freetronics/ServoShield/ServoShield.pdf

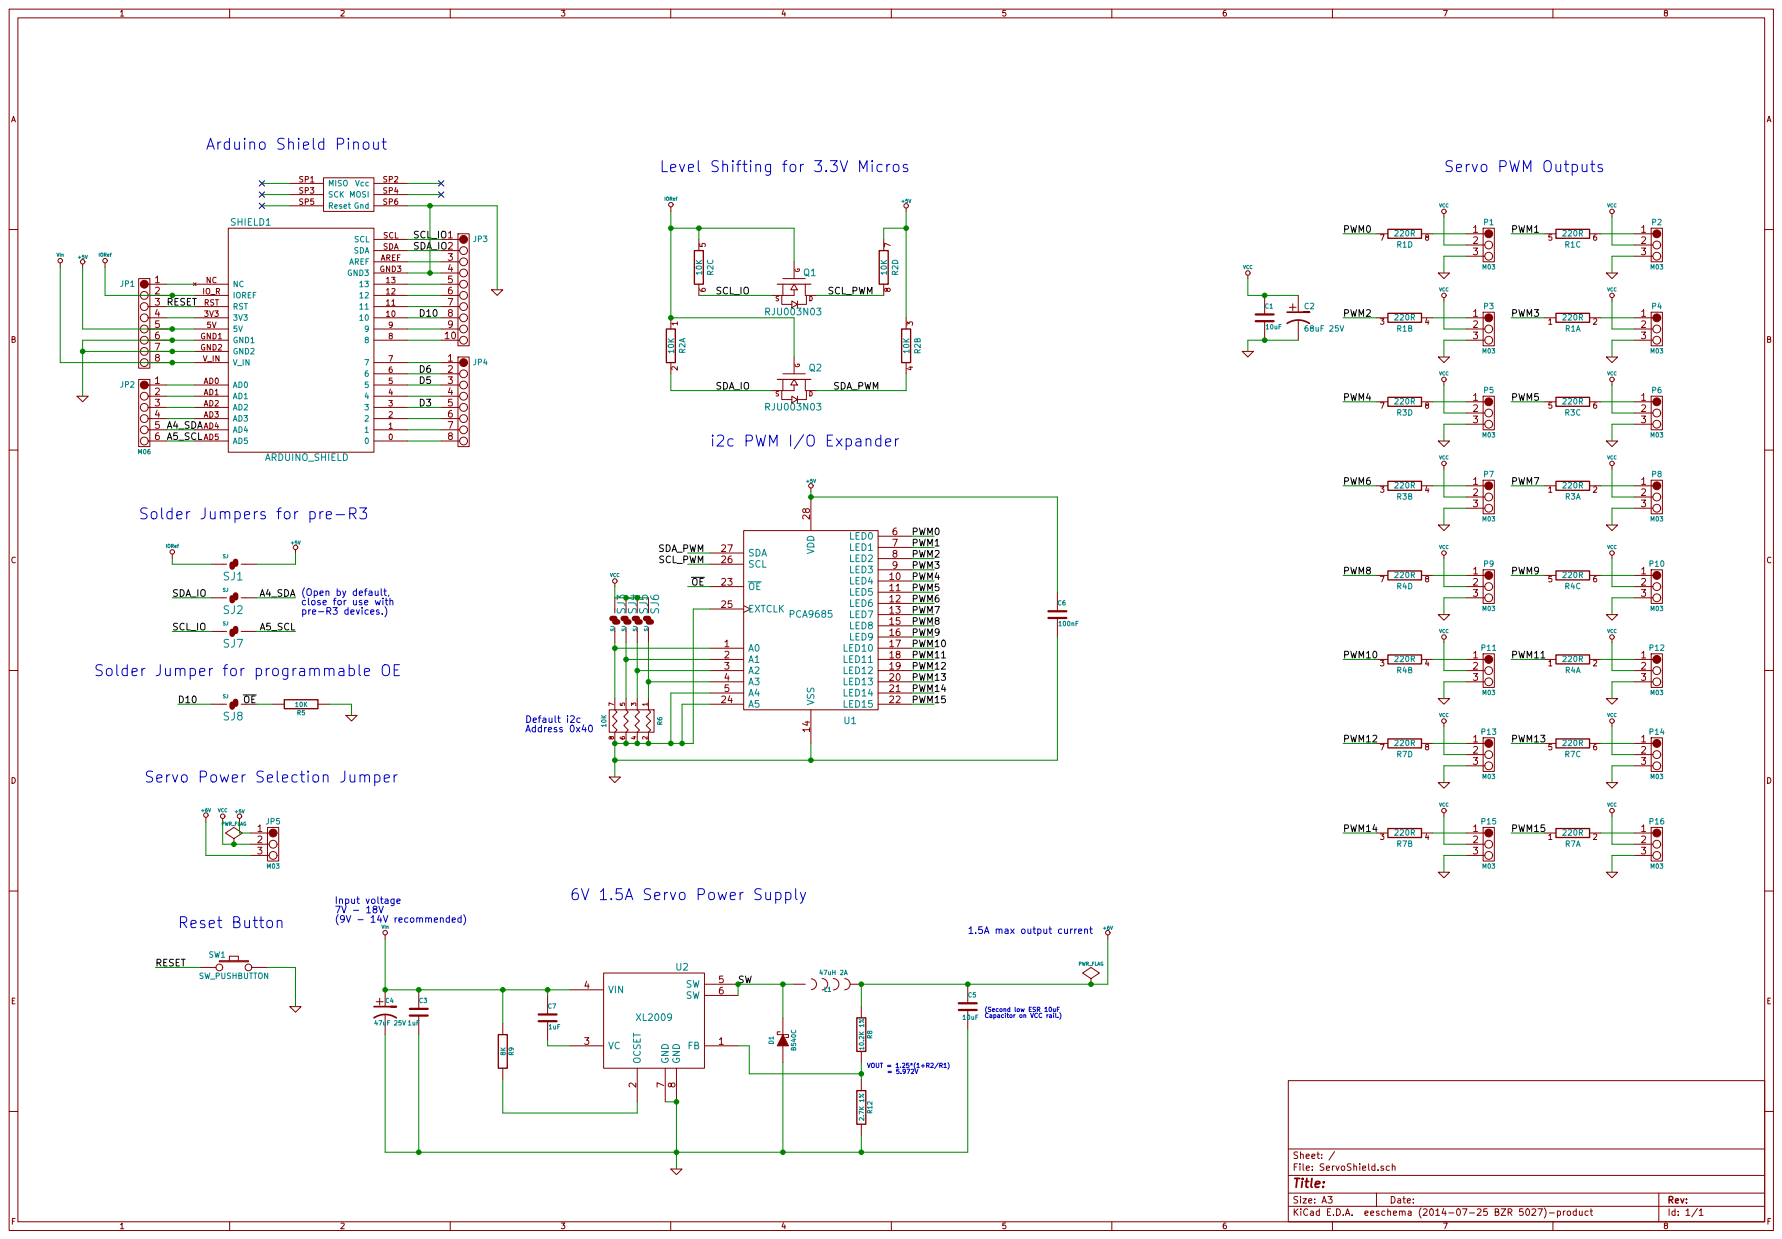
[picture p1: page 1]
