freetronics/ServoShield/ServoShield.kicad_pcb

## KiCad design ServoShield.kicad_pcb (2014-11-25)

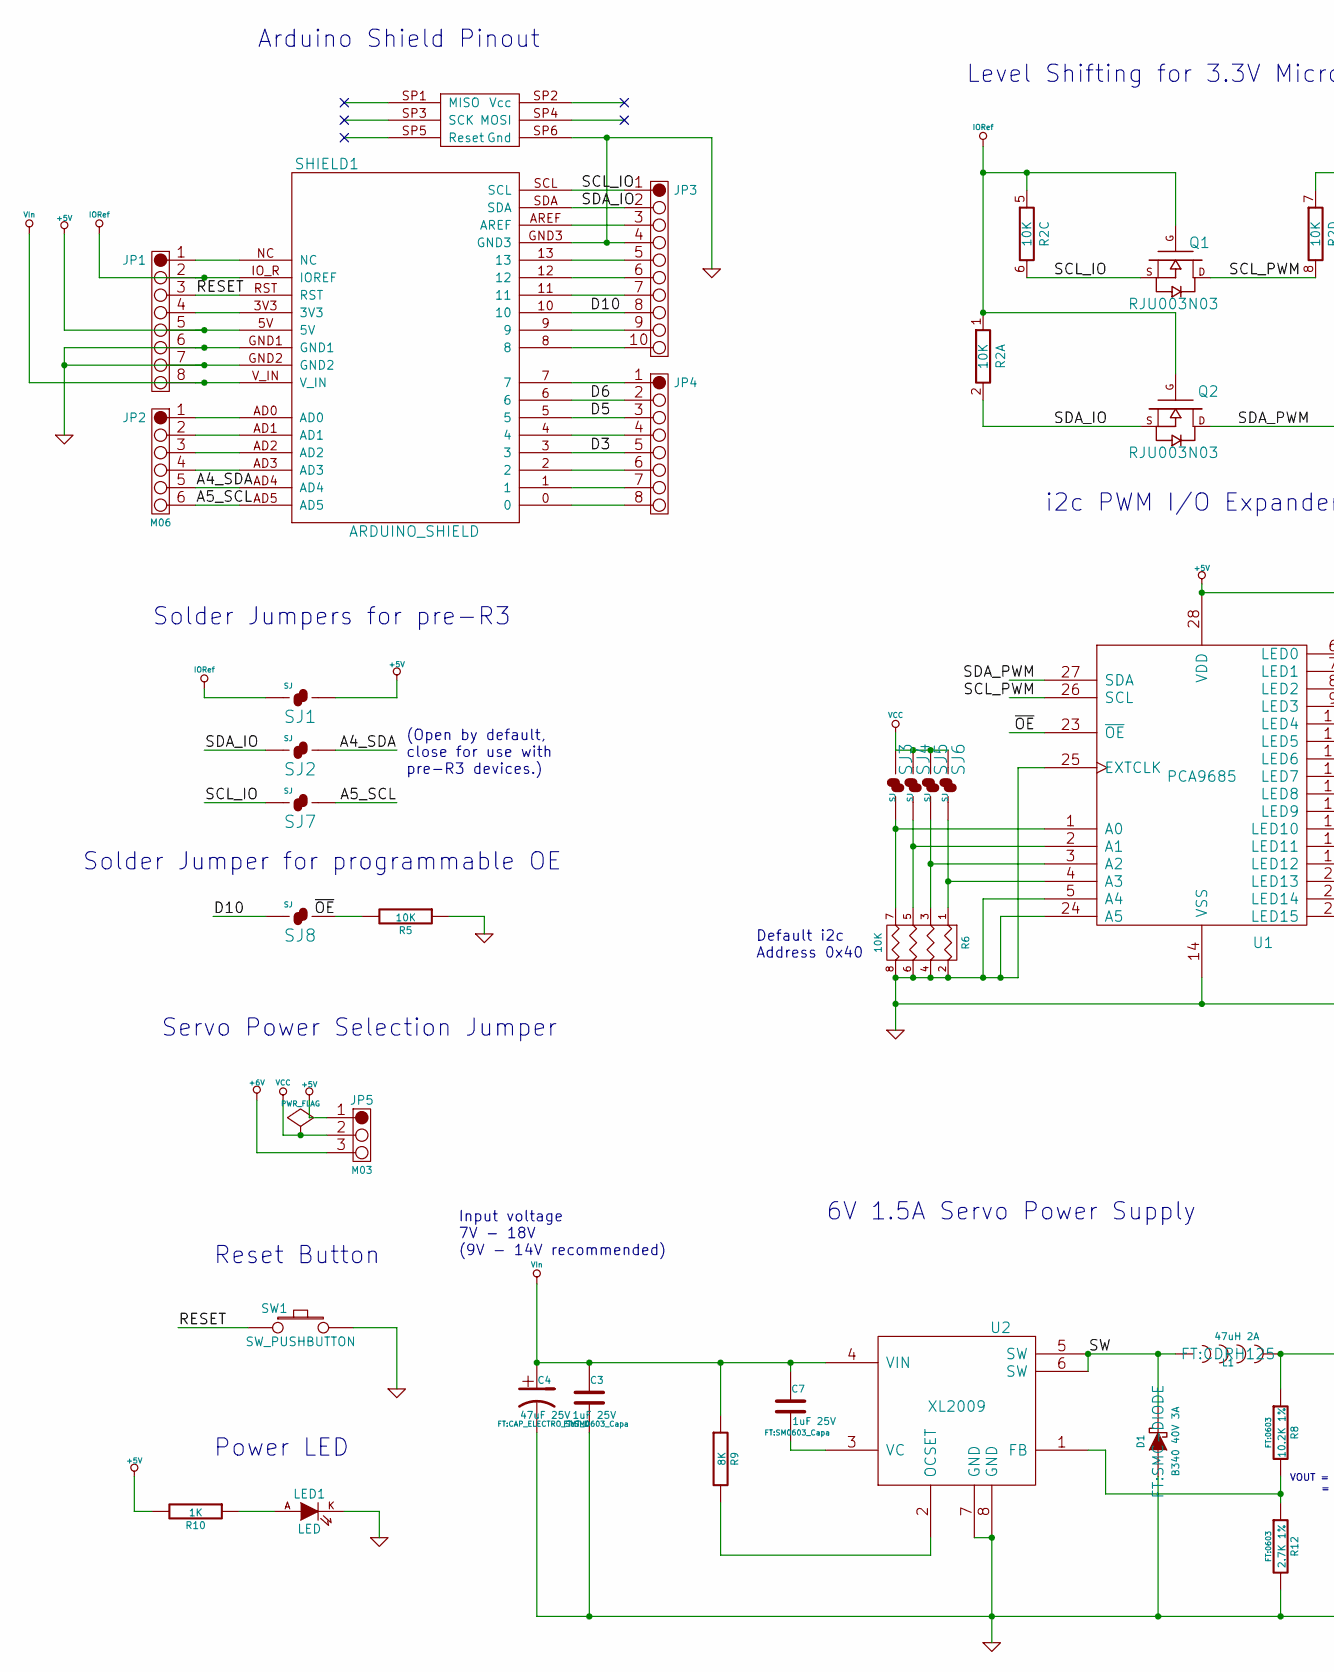
[picture p2: schematic ServoShield.sch, part in row 1, column 1]

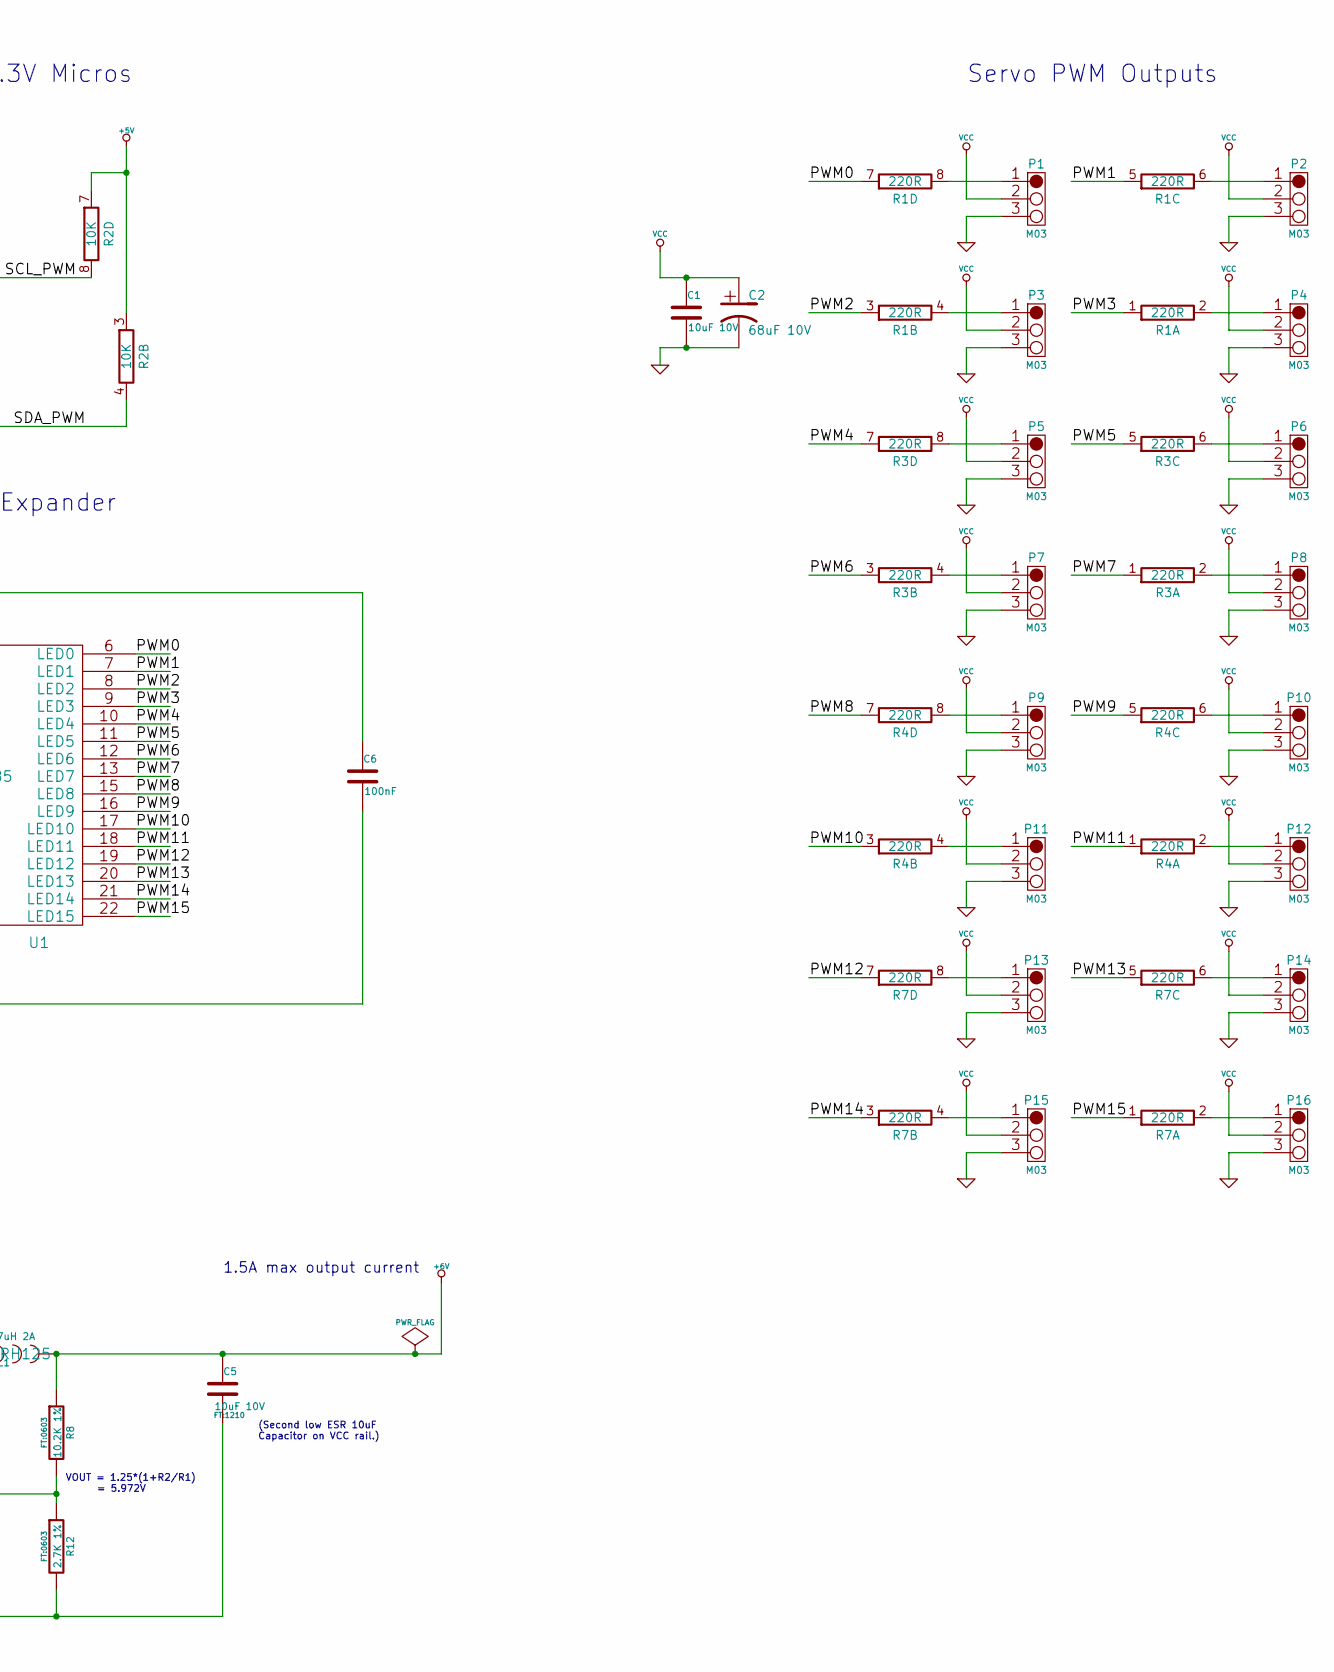
[picture p3: schematic ServoShield.sch, part in row 1, column 2]

Parts:
C1, C5: 10uF 10V; 1210
C2: 68uF 10V; CAP_ELECTRO_SMT_D
C3, C7: 1uF 25V; SM0603_Capa
C4: 47uF 25V; CAP_ELECTRO_SMT_D
C6: 100nF; SM0603_Capa
D1: B340 40V 3A; SMC-DIODE
JP1, JP4: M08; 1X08
JP2: M06; 1X06
JP3: M10; 1X10
JP5: M03; 1X03
L1: 47uH 2A; CDRH125
LED1: LED; LED-0603
P1, P2, P3, P4, P5, P6, P7, P8, P9, P10, P11, P12, P13, P14, P15, P16: M03; 1X03
Q1, Q2: RJU003N03; SOT323_MOSFET
R1, R3, R4, R7: 220R; RES_CAY16
R2, R6: 10K; RES_CAY16
R5: 10K; 0603
R8: 10.2K 1%; 0603
R9: 8K; 0603
R10: 1K; 0603
R12: 2.7K 1%; 0603
SHIELD1: ARDUINO_SHIELD
SJ1, SJ2, SJ3, SJ4, SJ5, SJ6, SJ7, SJ8: SJ; SJ_OPEN
SW1: SW_PUSHBUTTON; TACTILE_SWITCH_SMD_2PIN_TINY
U1: PCA9685; SSOP28-4.4MM
U2: XL2009; SO08

Connections:
+5V: C6.1, JP1.5, JP5.1, R2.3 (7), R2.7, R10.2, SHIELD1.5V, SJ1.2, U1.28 (VDD)
+6V: C5.1, JP5.3, L1.2, R8.1
/A4_SDA: JP2.5, SHIELD1.AD4, SJ2.2
/A5_SCL: JP2.6, SHIELD1.AD5, SJ7.2
/D3: JP4.5, SHIELD1.3
/D5: JP4.3, SHIELD1.5
/D6: JP4.2, SHIELD1.6
/D10: JP3.8, SHIELD1.10, SJ8.1
/PWM0: R1.7, U1.6 (LED0)
/PWM1: R1.5 (7), U1.7 (LED1)
/PWM2: R1.3 (7), U1.8 (LED2)
/PWM3: R1.1 (7), U1.9 (LED3)
/PWM4: R3.7, U1.10 (LED4)
/PWM5: R3.5 (7), U1.11 (LED5)
/PWM6: R3.3 (7), U1.12 (LED6)
/PWM7: R3.1 (7), U1.13 (LED7)
/PWM8: R4.7, U1.15 (LED8)
/PWM9: R4.5 (7), U1.16 (LED9)
/PWM10: R4.3 (7), U1.17 (LED10)
/PWM11: R4.1 (7), U1.18 (LED11)
/PWM12: R7.7, U1.19 (LED12)
/PWM13: R7.5 (7), U1.20 (LED13)
/PWM14: R7.3 (7), U1.21 (LED14)
/PWM15: R7.1 (7), U1.22 (LED15)
/RESET: JP1.3, SHIELD1.RST, SW1.1
/SCL_IO: JP3.1, Q1.S, R2.6 (8), SHIELD1.SCL, SJ7.1
/SCL_PWM: Q1.D, R2.8, U1.26 (SCL)
/SDA_IO: JP3.2, Q2.S, R2.2 (8), SHIELD1.SDA, SJ2.1
/SDA_PWM: Q2.D, R2.4 (8), U1.27 (SDA)
/SW: D1.K, L1.1, U2.5 (SW), U2.6 (SW)
/~OE: R5.2, SJ8.2, U1.23 (~OE)
GND: C1.2, C2.M, C3.2, C4.M, C5.2, C6.2, D1.A, JP1.6, JP1.7, JP3.4, LED1.K, P1.3, P2.3, P3.3, P4.3, P5.3, P6.3, P7.3, P8.3, P9.3, P10.3, P11.3, P12.3, P13.3, P14.3, P15.3, P16.3, R5.1, R6.2 (R1), R6.4 (R1), R6.6 (R3), R6.8 (R4), R12.2, SHIELD1.GND1, SHIELD1.GND2, SHIELD1.GND3, SHIELD1.SP6 (Gnd), SW1.2, U1.5 (A4), U1.14 (VSS), U1.24 (A5), U1.25 (EXTCLK), U2.7 (GND), U2.8 (GND)
IORef: JP1.2, Q1.G, Q2.G, R2.1 (7), R2.5 (7), SHIELD1.IO_R (IOREF), SJ1.1
unnamed: C7.2, U2.3 (VC)
unnamed: JP1.1, SHIELD1.NC
unnamed: JP1.4, SHIELD1.3V3
unnamed: JP2.1, SHIELD1.AD0
unnamed: JP2.2, SHIELD1.AD1
unnamed: JP2.3, SHIELD1.AD2
unnamed: JP2.4, SHIELD1.AD3
unnamed: JP3.3, SHIELD1.AREF
unnamed: JP3.5, SHIELD1.13
unnamed: JP3.6, SHIELD1.12
unnamed: JP3.7, SHIELD1.11
unnamed: JP3.9, SHIELD1.9
unnamed: JP3.10, SHIELD1.8
unnamed: JP4.1, SHIELD1.7
unnamed: JP4.4, SHIELD1.4
unnamed: JP4.6, SHIELD1.2
unnamed: JP4.7, SHIELD1.1
unnamed: JP4.8, SHIELD1.0
unnamed: LED1.A, R10.1
unnamed: P1.1, R1.8
unnamed: P2.1, R1.6 (8)
unnamed: P3.1, R1.4 (8)
unnamed: P4.1, R1.2 (8)
unnamed: P5.1, R3.8
unnamed: P6.1, R3.6 (8)
unnamed: P7.1, R3.4 (8)
unnamed: P8.1, R3.2 (8)
unnamed: P9.1, R4.8
unnamed: P10.1, R4.6 (8)
unnamed: P11.1, R4.4 (8)
unnamed: P12.1, R4.2 (8)
unnamed: P13.1, R7.8
unnamed: P14.1, R7.6 (8)
unnamed: P15.1, R7.4 (8)
unnamed: P16.1, R7.2 (8)
unnamed: R6.1, SJ6.1, U1.4 (A3)
unnamed: R6.3 (P2), SJ5.1, U1.3 (A2)
unnamed: R6.5 (P3), SJ4.1, U1.2 (A1)
unnamed: R6.7 (P4), SJ3.1, U1.1 (A0)
unnamed: R9.2, U2.2 (OCSET)
unnamed: R8.2, R12.1, U2.1 (FB)
VCC: C1.1, C2.P, JP5.2, P1.2, P2.2, P3.2, P4.2, P5.2, P6.2, P7.2, P8.2, P9.2, P10.2, P11.2, P12.2, P13.2, P14.2, P15.2, P16.2, SJ3.2, SJ4.2, SJ5.2, SJ6.2
VIn: C3.1, C4.P, C7.1, JP1.8, R9.1, SHIELD1.V_IN, U2.4 (VIN)

Notes on the sheet:
i2c PWM I/O Expander
Arduino Shield Pinout
Level Shifting for 3.3V Micros
Solder Jumpers for pre-R3
(Open by default, close for use with pre-R3 devices.)
Servo Power Selection Jumper
6V 1.5A Servo Power Supply
1.5A max output current
(Second low ESR 10uF Capacitor on VCC rail.)
Input voltage 7V - 18V (9V - 14V recommended)
Servo PWM Outputs
Reset Button
Solder Jumper for programmable OE
VOUT = 1.25*(1+R2/R1) = 5.972V
Default i2c Address 0x40
Power LED

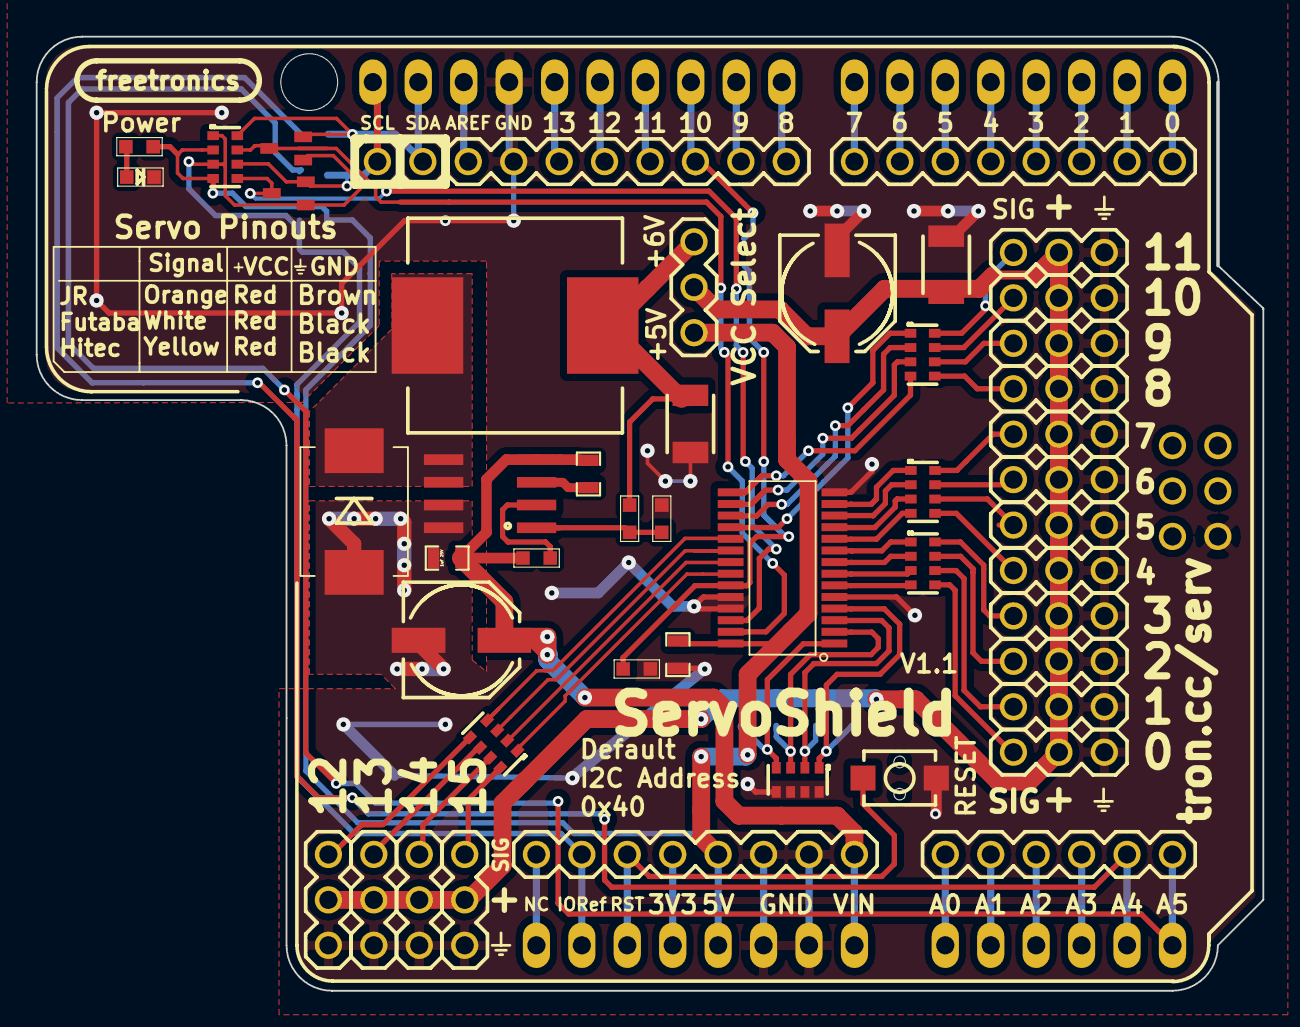
[picture p4: board ServoShield.kicad_pcb from above]

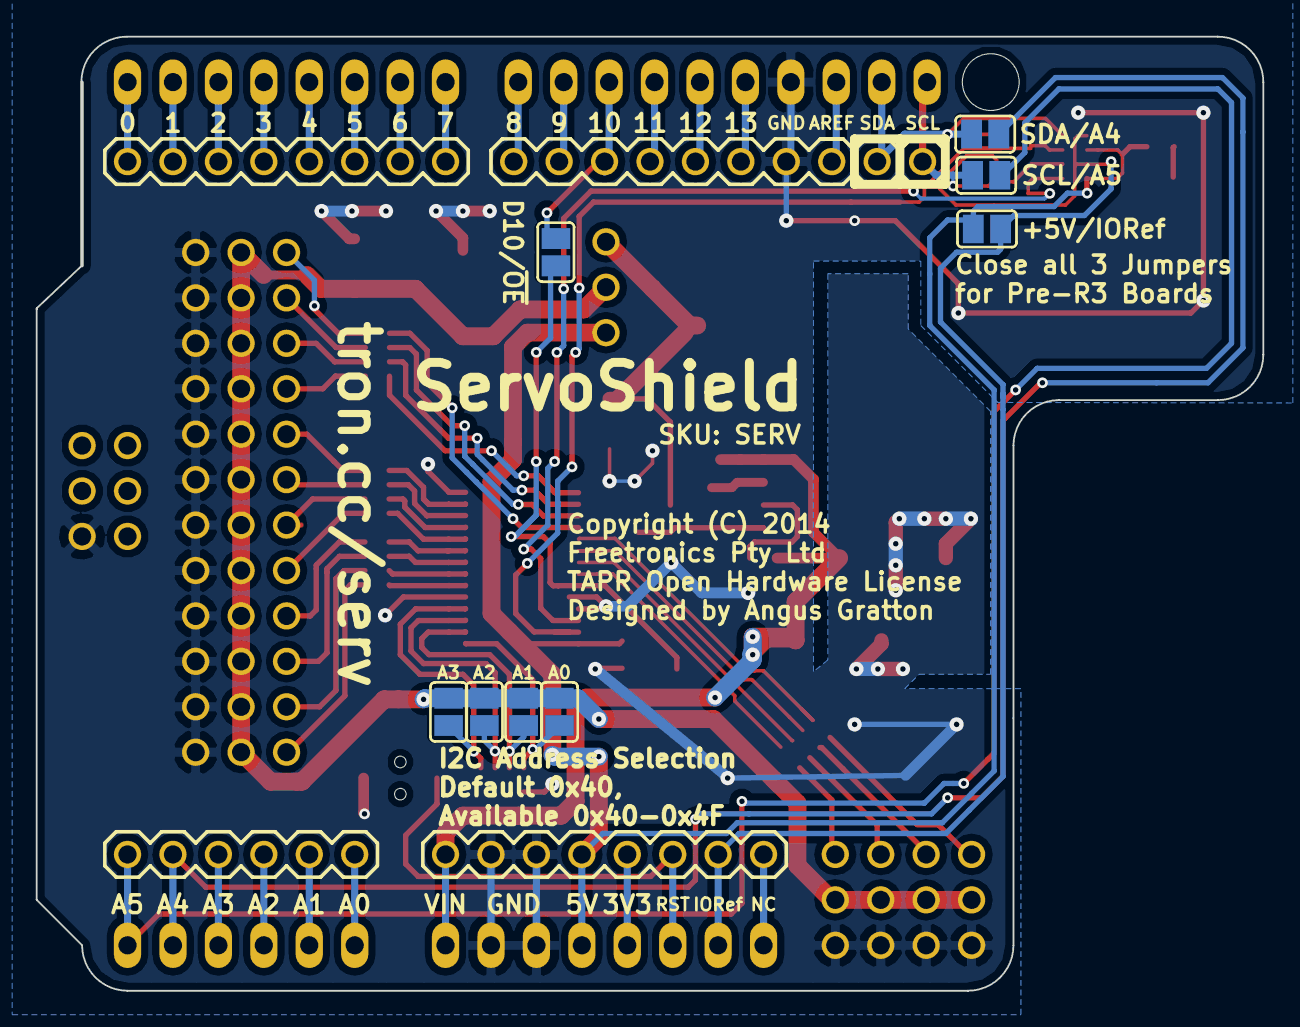
[picture p5: board ServoShield.kicad_pcb from below]

Board: 2 copper layers, 68.6 x 53.3 mm, 60 parts (8 on the bottom side), 76 nets.

Other parts of the board:
LOGO_FREETRONICS_SMALL: val**; LOGO_FREETRONICS_MIDSIZE
LOGO_GND_SILKSCREEN: VAL**; LOGO_GND_SILKSCREEN
LOGO_GND_SILKSCREEN#2, LOGO_GND_SILKSCREEN#3: VAL**; LOGO_GND_SILKSCREEN
