freetronics/ServoShield/(commit log)

2014-10-08 Initial routing pass
    [ServoShield.kicad_pcb, ServoShield.sch]
2014-10-21 Completed v1.0
    [ServoShield.kicad_pcb, ServoShield.sch]
2014-10-21 Such schematic PDF. Wow
2014-11-20 Small tweaks
    [ServoShield.kicad_pcb, ServoShield.sch]
2014-11-25 V1.1: Add power LED, fix SSOP footprint for PCA9685
    [ServoShield.kicad_pcb, ServoShield.sch]
