freetronics/ServoShield/(notices)

Notices in the files:
ServoShield.sch:
Licensed under TAPR Open Hardware License
Copyright (C) 2014 Freetronics Pty Ltd
